arachsys/nobmc/kicad/nobmc.kicad_pcb

## KiCad design kicad/nobmc.kicad_pcb (2026-07-16)

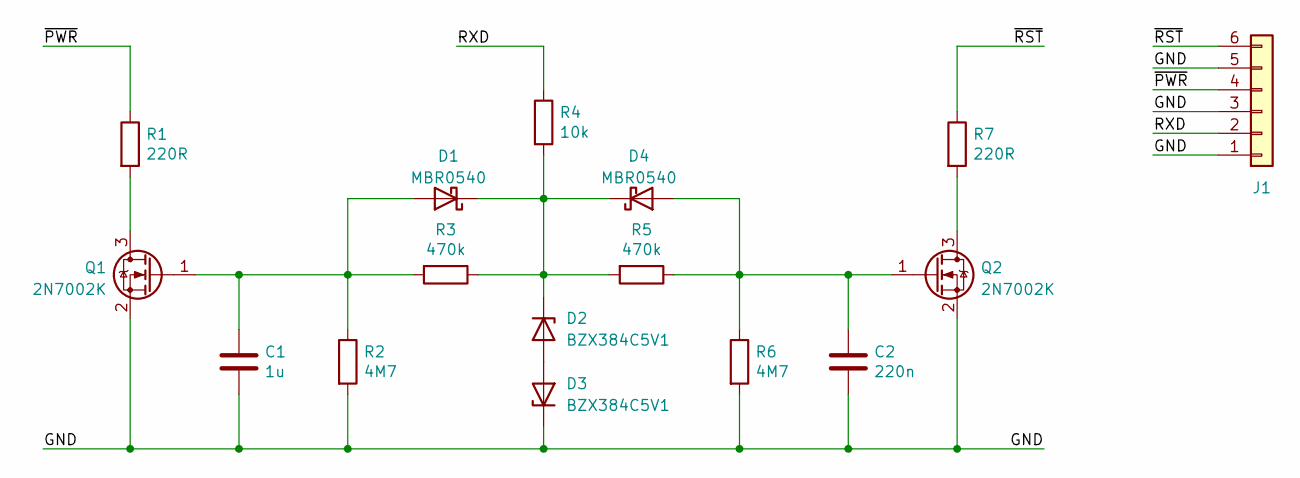
[picture p2: schematic nobmc.kicad_sch]

Parts:
C1: 1u; C_0805_2012Metric
C2: 220n; C_0805_2012Metric
D1, D4: MBR0540; D_SOD-123
D2, D3: BZX384C5V1; D_SOD-323
J1: Conn_01x06; PinHeader_1x06_P2.54mm_Horizontal
Q1, Q2: 2N7002K; SOT-23
R1, R7: 220R; R_0603_1608Metric
R2, R6: 4M7; R_0603_1608Metric
R3, R5: 470k; R_0603_1608Metric
R4: 10k; R_0603_1608Metric

Connections:
/GND: C1.2, C2.2, D3.1 (K), J1.1, J1.3, J1.5, Q1.2 (S), Q2.2 (S), R2.2, R6.2
/RXD: J1.2, R4.1
/~PWR: J1.4, R1.1
/~RST: J1.6, R7.1
unnamed: C1.1, D1.2 (A), Q1.1 (G), R2.1, R3.2
unnamed: D1.1 (K), D2.1 (K), D4.1 (K), R3.1, R4.2, R5.2
unnamed: D2.2 (A), D3.2 (A)
unnamed: C2.1, D4.2 (A), Q2.1 (G), R5.1, R6.1
unnamed: Q1.3 (D), R1.2
unnamed: Q2.3 (D), R7.2

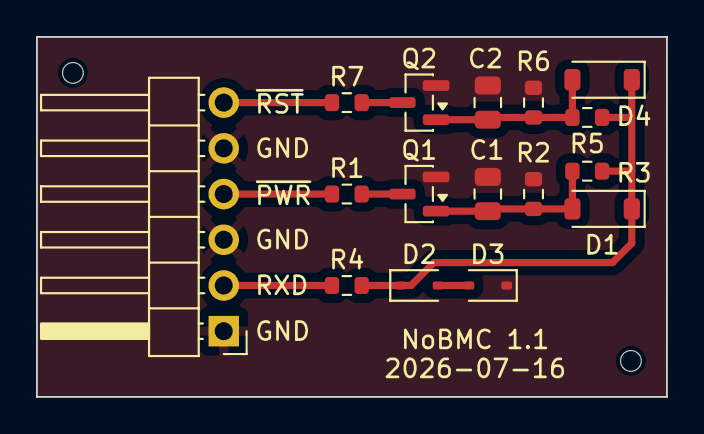
[picture p3: board nobmc.kicad_pcb from above]

Board: 2 copper layers, 35.0 x 20.0 mm, 18 parts (0 on the bottom side), 10 nets.

Other parts of the board:
HOLE: ToolingHole_1.152mm
HOLE#2: ToolingHole_1.152mm
