arachsys/nobmc/(commit log)

2023-02-26 Import initial version
    [nobmc.kicad_pcb, nobmc.kicad_sch]
2026-07-16 Refresh with Kicad 9.0
    [nobmc.kicad_pcb, nobmc.kicad_sch]
